BrunoRicci/DataloggerDHT22/Hardware/README.txt

Hardware files.
Schematics, simulations, measurements, PCB layouts and mechanical diagrams.
