BrunoRicci/DataloggerDHT22/Documentation/README.txt

Documentations for every project section and stage.
