BrunoRicci/DataloggerDHT22/Documentation/Web dashboard/last_connection_table.png

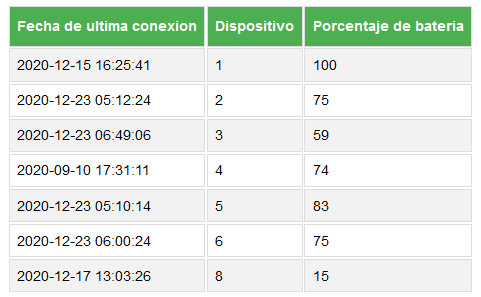
Documentation/Web dashboard/last_connection_table.png
