BrunoRicci/DataloggerDHT22/Hardware/Datalogger_esp8266/3d model/3d_complete.FCStd

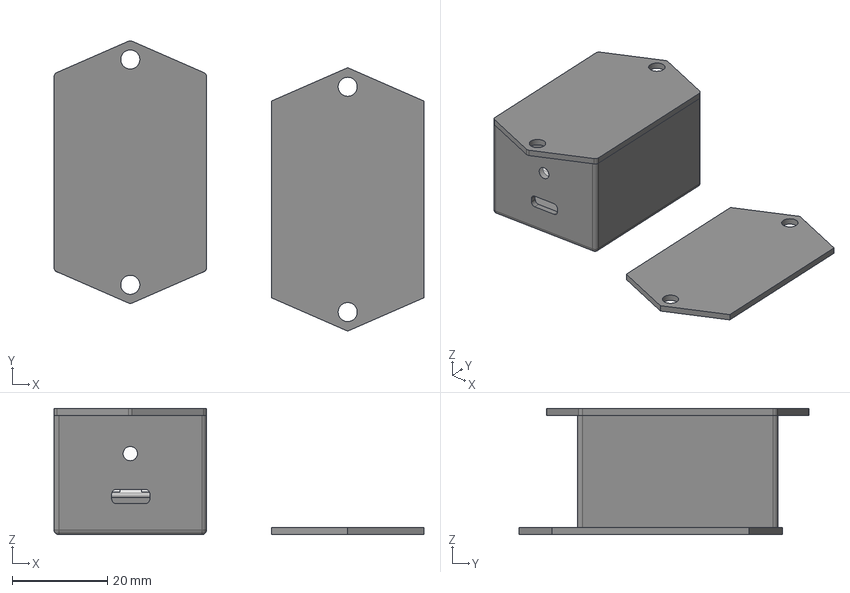
[picture p2: CAD file, 2020-11-16]
Hardware/Datalogger_esp8266/3d model/3d_complete.FCStd
77.6 x 60.9 x 26.5 mm
Battery
Cabinet_drilled
Cabinet_cover
LED_cover
