BrunoRicci/DataloggerDHT22/Hardware/Datalogger_esp8266/3d model/Datalogger_3d_pcb.step

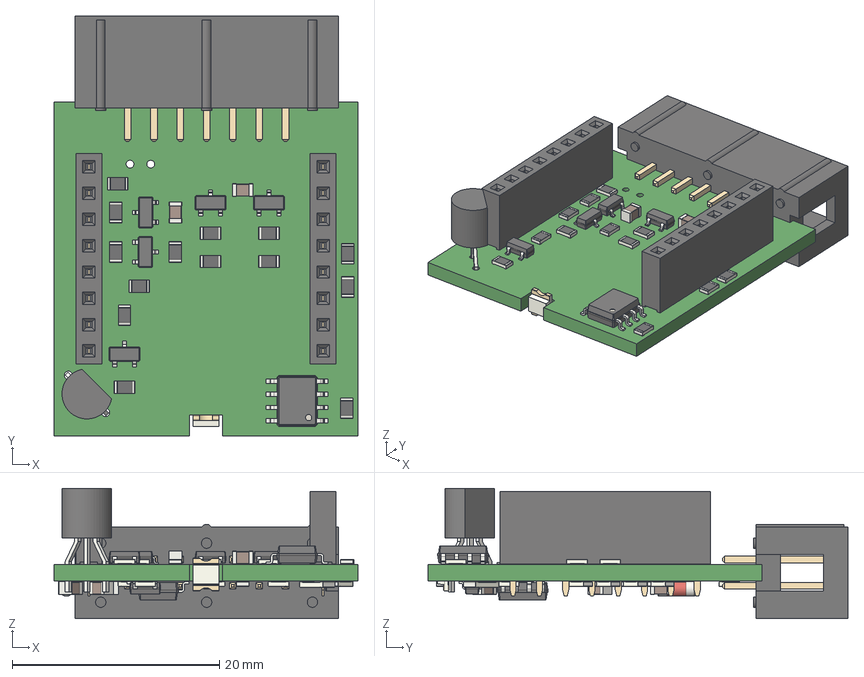
[picture p3: CAD file, 2020-11-16]
Hardware/Datalogger_esp8266/3d model/Datalogger_3d_pcb.step
29.4 x 40.5 x 12.6 mm
