BrunoRicci/DataloggerDHT22/Hardware/Datalogger_esp8266/LIR2477_battery_holder/LIR2477_battery_holder.FCStd

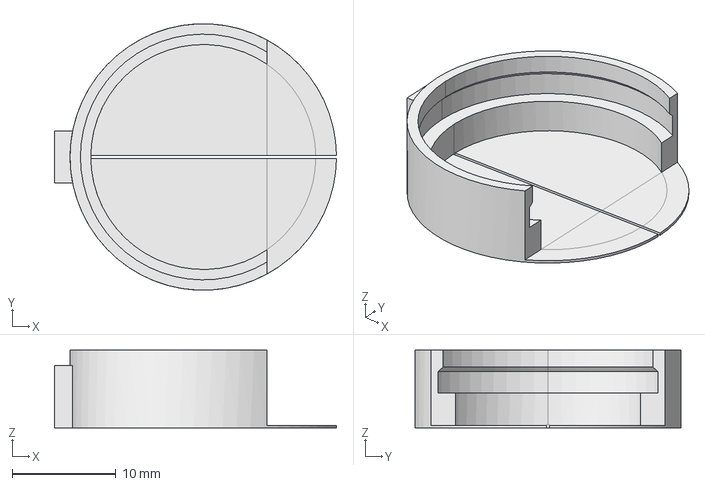
[picture p4: CAD file, 2020-06-24]
Hardware/Datalogger_esp8266/LIR2477_battery_holder/LIR2477_battery_holder.FCStd
27.2 x 25.7 x 7.50 mm
