BrunoRicci/DataloggerDHT22/(list of files, cad)

Other CAD files:
Hardware/Datalogger_esp8266/LIR2477_battery_holder/battery_holder.stl
Hardware/Datalogger_esp8266/3d model/3d_views.FCStd
