BrunoRicci/DataloggerDHT22/Documentation/Testing scripts/README.txt

Scripts for testing system performance and behaviors.
