BrunoRicci/DataloggerDHT22/Documentation/Testing scripts/Datos dataloggers/DATOS_06-08-2020/datos_23-07-2020_06-08-2020.csv

TIMESTAMP | DATE_TIME | ID_SENSOR | TEMPERATURE | HUMIDITY
1596744298 | 2020-08-06 17:04:58 | 1 | -0.1 | 255.0
1596744298 | 2020-08-06 17:04:58 | 2 | -0.1 | 255.0
1596744298 | 2020-08-06 17:04:58 | 3 | -0.1 | 255.0
1596744298 | 2020-08-06 17:04:58 | 4 | -0.1 | 255.0
1596740699 | 2020-08-06 16:04:59 | 1 | -0.1 | 255.0
1596740699 | 2020-08-06 16:04:59 | 2 | -0.1 | 255.0
1596740699 | 2020-08-06 16:04:59 | 3 | -0.1 | 255.0
1596740699 | 2020-08-06 16:04:59 | 4 | -0.1 | 255.0
1596737202 | 2020-08-06 15:06:42 | 17 | -0.1 | 255.0
1596737202 | 2020-08-06 15:06:42 | 18 | -0.1 | 255.0
1596737202 | 2020-08-06 15:06:42 | 19 | -0.1 | 255.0
1596737202 | 2020-08-06 15:06:42 | 20 | -0.1 | 255.0
1596737156 | 2020-08-06 15:05:56 | 13 | -0.1 | 255.0
1596737156 | 2020-08-06 15:05:56 | 14 | -0.1 | 255.0
1596737156 | 2020-08-06 15:05:56 | 15 | -0.1 | 255.0
1596737156 | 2020-08-06 15:05:56 | 16 | -0.1 | 255.0
1596737136 | 2020-08-06 15:05:36 | 9 | -0.1 | 255.0
1596737136 | 2020-08-06 15:05:36 | 10 | -0.1 | 255.0
1596737136 | 2020-08-06 15:05:36 | 11 | -0.1 | 255.0
1596737136 | 2020-08-06 15:05:36 | 12 | -0.1 | 255.0
1596737126 | 2020-08-06 15:05:26 | 5 | -0.1 | 255.0
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
