BrunoRicci/DataloggerDHT22/Documentation/Testing scripts/Datos dataloggers/DATOS_06-08-2020/datos_23-07-2020_06-08-2020.ods

TIMESTAMP | DATE_TIME | ID_SENSOR | TEMPERATURE | HUMIDITY
1595531435 | 2020-07-23 16:10:35 | 1
1595531436 | 2020-07-23 16:10:36 | 1
1595531437 | 2020-07-23 16:10:37 | 1
1595531438 | 2020-07-23 16:10:38 | 1
1595535034 | 2020-07-23 17:10:34 | 1
1595535035 | 2020-07-23 17:10:35 | 1
1595535036 | 2020-07-23 17:10:36 | 1
1595535037 | 2020-07-23 17:10:37 | 1
1595538633 | 2020-07-23 18:10:33 | 1
1595538634 | 2020-07-23 18:10:34 | 1
1595538635 | 2020-07-23 18:10:35 | 1
1595538636 | 2020-07-23 18:10:36 | 1
1595542232 | 2020-07-23 19:10:32 | 1
1595542233 | 2020-07-23 19:10:33 | 1
1595542234 | 2020-07-23 19:10:34 | 1
1595542235 | 2020-07-23 19:10:35 | 1
1595545831 | 2020-07-23 20:10:31 | 1
1595545832 | 2020-07-23 20:10:32 | 1
1595545833 | 2020-07-23 20:10:33 | 1
1595545834 | 2020-07-23 20:10:34 | 1
1595549430 | 2020-07-23 21:10:30 | 1
1595549431 | 2020-07-23 21:10:31 | 1
1595549432 | 2020-07-23 21:10:32 | 1
1595549433 | 2020-07-23 21:10:33 | 1
1595553029 | 2020-07-23 22:10:29 | 1
1595553030 | 2020-07-23 22:10:30 | 1
1595553031 | 2020-07-23 22:10:31 | 1
1595553032 | 2020-07-23 22:10:32 | 1
1595556628 | 2020-07-23 23:10:28 | 1
1595556629 | 2020-07-23 23:10:29 | 1
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
