BrunoRicci/DataloggerDHT22/Documentation/Testing scripts/Datos dataloggers/1/data_1_15-06-2020_30-06-2020.ods

ID_SENSOR | TEMPERATURE | HUMIDITY | Date | Time
4 |  |  | 15/06/20 | 14:30:00
3 |  |  | 15/06/20 | 14:30:00
2 |  |  | 15/06/20 | 14:30:00
1 |  |  | 15/06/20 | 14:30:00
4 |  |  | 15/06/20 | 15:29:59
3 |  |  | 15/06/20 | 15:29:59
2 |  |  | 15/06/20 | 15:29:59
1 |  |  | 15/06/20 | 15:29:59
4 |  |  | 15/06/20 | 16:29:58
3 |  |  | 15/06/20 | 16:29:58
2 |  |  | 15/06/20 | 16:29:58
1 |  |  | 15/06/20 | 16:29:58
4 | 4.4 | 50.0 | 15/06/20 | 17:29:57
3 | 5.3 | 57.0 | 15/06/20 | 17:29:57
2 | 4.7 | 51.0 | 15/06/20 | 17:29:57
1 | 5.0 | 55.0 | 15/06/20 | 17:29:57
4 | 3.8 | 49.0 | 15/06/20 | 18:29:56
3 | 4.3 | 56.0 | 15/06/20 | 18:29:56
2 | 4.2 | 51.0 | 15/06/20 | 18:29:56
1 | 4.2 | 55.0 | 15/06/20 | 18:29:56
4 | 3.8 | 49.0 | 15/06/20 | 19:29:55
3 | 4.3 | 56.0 | 15/06/20 | 19:29:55
2 | 4.2 | 51.0 | 15/06/20 | 19:29:55
1 | 4.2 | 55.0 | 15/06/20 | 19:29:55
4 | 3.8 | 49.0 | 15/06/20 | 20:29:53
3 | 4.3 | 56.0 | 15/06/20 | 20:29:53
2 | 4.2 | 51.0 | 15/06/20 | 20:29:53
1 | 4.2 | 55.0 | 15/06/20 | 20:29:53
4 | 3.8 | 49.0 | 15/06/20 | 21:29:52
3 | 4.3 | 56.0 | 15/06/20 | 21:29:52
2 | 4.2 | 51.0 | 15/06/20 | 21:29:52
1 | 4.1 | 55.0 | 15/06/20 | 21:29:52
4 | 4.4 | 50.0 | 15/06/20 | 22:29:51
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
