BrunoRicci/DataloggerDHT22/Documentation/Testing scripts/Datos dataloggers/1/data_1_v2.ods

TIMESTAMP | DATE_TIME | ID_SENSOR | TEMPERATURE | HUMIDITY | Date | Time | Corrected timestamp | Corrected time | Correction timestamp
1590055279 | 2020-05-21 07:01:19 | 4 | -0.1 | 255.0 | 15/06/20 | 12:32:24 | 1592235144 | 43997,5225 | 2179865
1590055279 | 2020-05-21 07:01:19 | 3 | -0.1 | 255.0 | 15/06/20 | 12:32:24 | 1592235144 | 43997,5225
1590055279 | 2020-05-21 07:01:19 | 2 | -0.1 | 255.0 | 15/06/20 | 12:32:24 | 1592235144 | 43997,5225
1590055279 | 2020-05-21 07:01:19 | 1 | -0.1 | 255.0 | 15/06/20 | 12:32:24 | 1592235144 | 43997,5225
1590062335 | 2020-05-21 08:58:55 | 4 | -0.1 | 255.0 | 15/06/20 | 14:30:00 | 1592242200 | 43997,6041666667
1590062335 | 2020-05-21 08:58:55 | 3 | -0.1 | 255.0 | 15/06/20 | 14:30:00 | 1592242200 | 43997,6041666667
1590062335 | 2020-05-21 08:58:55 | 2 | -0.1 | 255.0 | 15/06/20 | 14:30:00 | 1592242200 | 43997,6041666667
1590062335 | 2020-05-21 08:58:55 | 1 | -0.1 | 255.0 | 15/06/20 | 14:30:00 | 1592242200 | 43997,6041666667
1590065934 | 2020-05-21 09:58:54 | 4 | -0.1 | 255.0 | 15/06/20 | 15:29:59 | 1592245799 | 43997,6458217593
1590065934 | 2020-05-21 09:58:54 | 3 | -0.1 | 255.0 | 15/06/20 | 15:29:59 | 1592245799 | 43997,6458217593
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
