BrunoRicci/DataloggerDHT22/Documentation/Testing scripts/Datos dataloggers/2/data_2_15-06-2020_30-06-2020.ods

ID_SENSOR | TEMPERATURE | HUMIDITY | Date | Time
4 |  |  | 15/06/20 | 12:53:00
3 |  |  | 15/06/20 | 12:53:00
2 |  |  | 15/06/20 | 12:53:00
1 |  |  | 15/06/20 | 12:53:00
4 |  |  | 15/06/20 | 13:52:59
3 |  |  | 15/06/20 | 13:52:59
2 |  |  | 15/06/20 | 13:52:59
1 |  |  | 15/06/20 | 13:52:59
4 |  |  | 15/06/20 | 14:52:58
3 |  |  | 15/06/20 | 14:52:58
2 |  |  | 15/06/20 | 14:52:58
1 |  |  | 15/06/20 | 14:52:58
4 | 9.4 | 80.0 | 15/06/20 | 15:52:57
3 | 9.9 | 58.0 | 15/06/20 | 15:52:57
2 | 9.9 | 57.0 | 15/06/20 | 15:52:57
1 | 9.8 | 61.0 | 15/06/20 | 15:52:57
4 | 9.4 | 80.0 | 15/06/20 | 16:52:56
3 | 9.9 | 58.0 | 15/06/20 | 16:52:56
2 | 9.8 | 57.0 | 15/06/20 | 16:52:56
1 | 9.9 | 62.0 | 15/06/20 | 16:52:56
4 | 9.4 | 80.0 | 15/06/20 | 17:52:55
3 | 9.9 | 58.0 | 15/06/20 | 17:52:55
2 | 9.9 | 57.0 | 15/06/20 | 17:52:55
1 | 9.9 | 62.0 | 15/06/20 | 17:52:55
4 | 9.4 | 80.0 | 15/06/20 | 18:52:54
3 | 9.9 | 58.0 | 15/06/20 | 18:52:54
2 | 9.9 | 57.0 | 15/06/20 | 18:52:54
1 | 9.9 | 61.0 | 15/06/20 | 18:52:54
4 | 9.4 | 80.0 | 15/06/20 | 19:52:53
3 | 9.9 | 58.0 | 15/06/20 | 19:52:53
2 | 9.9 | 57.0 | 15/06/20 | 19:52:53
1 | 9.9 | 62.0 | 15/06/20 | 19:52:53
4 | 9.4 | 80.0 | 15/06/20 | 20:52:52
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
