BrunoRicci/DataloggerDHT22/Documentation/Testing scripts/Datos dataloggers/3/data_3_15-06-2020_30-06-2020.ods

ID_SENSOR | TEMPERATURE | HUMIDITY | Date | Time
4 | -0.1 | 255.0 | 15/06/20 | 14:45:00
3 | -0.1 | 255.0 | 15/06/20 | 14:45:00
2 | -0.1 | 255.0 | 15/06/20 | 14:45:00
1 | -0.1 | 255.0 | 15/06/20 | 14:45:00
4 | -0.1 | 255.0 | 15/06/20 | 15:44:58
3 | -0.1 | 255.0 | 15/06/20 | 15:44:58
2 | -0.1 | 255.0 | 15/06/20 | 15:44:58
1 | -0.1 | 255.0 | 15/06/20 | 15:44:58
4 | -0.1 | 255.0 | 15/06/20 | 16:44:57
3 | -0.1 | 255.0 | 15/06/20 | 16:44:57
2 | -0.1 | 255.0 | 15/06/20 | 16:44:57
1 | -0.1 | 255.0 | 15/06/20 | 16:44:57
4 | 11.9 | 53.0 | 15/06/20 | 17:44:56
3 | 11.7 | 51.0 | 15/06/20 | 17:44:56
2 | 12.0 | 53.0 | 15/06/20 | 17:44:56
1 | 12.0 | 58.0 | 15/06/20 | 17:44:56
4 | 11.5 | 52.0 | 15/06/20 | 18:44:55
3 | 11.4 | 51.0 | 15/06/20 | 18:44:55
2 | 11.6 | 53.0 | 15/06/20 | 18:44:55
1 | 11.6 | 58.0 | 15/06/20 | 18:44:55
4 | 11.5 | 52.0 | 15/06/20 | 19:44:54
3 | 11.4 | 51.0 | 15/06/20 | 19:44:54
2 | 11.6 | 53.0 | 15/06/20 | 19:44:54
1 | 11.6 | 58.0 | 15/06/20 | 19:44:54
4 | 13.6 | 54.0 | 15/06/20 | 20:44:53
3 | 13.5 | 53.0 | 15/06/20 | 20:44:53
2 | 13.7 | 55.0 | 15/06/20 | 20:44:53
1 | 13.8 | 60.0 | 15/06/20 | 20:44:53
4 | 16.6 | 54.0 | 15/06/20 | 21:44:52
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
