BrunoRicci/DataloggerDHT22/Documentation/Testing scripts/Datos dataloggers/3/data_3_2.csv

TIMESTAMP | DATE_TIME | ID_SENSOR | TEMPERATURE | HUMIDITY
1 | 1969-12-31 21:00:01 | 1 | 22.3 | 75.0
1 | 1969-12-31 21:00:01 | 2 | 22.1 | 70.0
1 | 1969-12-31 21:00:01 | 3 | 22.3 | 77.0
1 | 1969-12-31 21:00:01 | 4 | 22.5 | 76.0
300 | 1969-12-31 21:05:00 | 1 | 22.1 | 75.0
300 | 1969-12-31 21:05:00 | 2 | 22.0 | 70.0
300 | 1969-12-31 21:05:00 | 3 | 22.2 | 77.0
300 | 1969-12-31 21:05:00 | 4 | 22.4 | 76.0
599 | 1969-12-31 21:09:59 | 1 | 22.2 | 76.0
599 | 1969-12-31 21:09:59 | 2 | 22.0 | 71.0
599 | 1969-12-31 21:09:59 | 3 | 22.2 | 78.0
599 | 1969-12-31 21:09:59 | 4 | 22.3 | 77.0
898 | 1969-12-31 21:14:58 | 1 | 22.1 | 75.0
898 | 1969-12-31 21:14:58 | 2 | 22.0 | 70.0
898 | 1969-12-31 21:14:58 | 3 | 22.2 | 78.0
898 | 1969-12-31 21:14:58 | 4 | 22.4 | 77.0
1197 | 1969-12-31 21:19:57 | 1 | 22.2 | 76.0
1197 | 1969-12-31 21:19:57 | 2 | 22.1 | 71.0
1197 | 1969-12-31 21:19:57 | 3 | 22.3 | 80.0
1197 | 1969-12-31 21:19:57 | 4 | 22.4 | 78.0
1496 | 1969-12-31 21:24:56 | 1 | 22.3 | 75.0
1496 | 1969-12-31 21:24:56 | 2 | 22.1 | 70.0
1496 | 1969-12-31 21:24:56 | 3 | 22.3 | 77.0
1496 | 1969-12-31 21:24:56 | 4 | 22.5 | 75.0
1795 | 1969-12-31 21:29:55 | 1 | 22.2 | 75.0
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
