BrunoRicci/DataloggerDHT22/Documentation/Testing scripts/Datos dataloggers/4/data_4_15-06-2020_30-06-2020.ods

ID_SENSOR | TEMPERATURE | HUMIDITY | Date | Time
4 | -0.1 | 255.0 | 15/06/20 | 09:07:04
3 | -0.1 | 255.0 | 15/06/20 | 09:07:04
2 | -0.1 | 255.0 | 15/06/20 | 09:07:04
1 | 18.4 | 58.0 | 15/06/20 | 09:07:04
4 | -0.1 | 255.0 | 15/06/20 | 10:07:03
3 | -0.1 | 255.0 | 15/06/20 | 10:07:03
2 | -0.1 | 255.0 | 15/06/20 | 10:07:03
1 | 19.4 | 59.0 | 15/06/20 | 10:07:03
4 | -0.1 | 255.0 | 15/06/20 | 11:07:02
3 | -0.1 | 255.0 | 15/06/20 | 11:07:02
2 | -0.1 | 255.0 | 15/06/20 | 11:07:02
1 | 19.6 | 59.0 | 15/06/20 | 11:07:02
4 | -0.1 | 255.0 | 15/06/20 | 12:07:01
3 | -0.1 | 255.0 | 15/06/20 | 12:07:01
2 | -0.1 | 255.0 | 15/06/20 | 12:07:01
1 | 19.7 | 59.0 | 15/06/20 | 12:07:01
4 | -0.1 | 255.0 | 15/06/20 | 13:07:00
3 | -0.1 | 255.0 | 15/06/20 | 13:07:00
2 | -0.1 | 255.0 | 15/06/20 | 13:07:00
1 | -0.1 | 255.0 | 15/06/20 | 13:07:00
4 | -0.1 | 255.0 | 15/06/20 | 14:06:59
3 | -0.1 | 255.0 | 15/06/20 | 14:06:59
2 | -0.1 | 255.0 | 15/06/20 | 14:06:59
1 | -0.1 | 255.0 | 15/06/20 | 14:06:59
4 | -0.1 | 255.0 | 15/06/20 | 15:06:58
3 | -0.1 | 255.0 | 15/06/20 | 15:06:58
2 | -0.1 | 255.0 | 15/06/20 | 15:06:58
1 | 19.5 | 59.0 | 15/06/20 | 15:06:58
4 | -0.1 | 255.0 | 15/06/20 | 16:06:57
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
