BrunoRicci/DataloggerDHT22/Documentation/Testing scripts/Datos dataloggers/5/data_5_15-06-2020_30-06-2020.ods

ID_SENSOR | TEMPERATURE | HUMIDITY | Date | Time
4 |  |  | 15/06/20 | 13:20:00
3 |  |  | 15/06/20 | 13:20:00
2 |  |  | 15/06/20 | 13:20:00
1 |  |  | 15/06/20 | 13:20:00
4 |  |  | 15/06/20 | 14:19:59
3 |  |  | 15/06/20 | 14:19:59
2 |  |  | 15/06/20 | 14:19:59
1 |  |  | 15/06/20 | 14:19:59
4 |  |  | 15/06/20 | 15:19:58
3 |  |  | 15/06/20 | 15:19:58
2 |  |  | 15/06/20 | 15:19:58
1 |  |  | 15/06/20 | 15:19:58
4 | 29.4 | 52.0 | 15/06/20 | 16:19:57
3 | 29.7 | 51.0 | 15/06/20 | 16:19:57
2 | 29.1 | 51.0 | 15/06/20 | 16:19:57
1 | 29.6 | 55.0 | 15/06/20 | 16:19:57
4 | 29.1 | 52.0 | 15/06/20 | 17:19:56
3 | 29.5 | 51.0 | 15/06/20 | 17:19:56
2 | 29.0 | 51.0 | 15/06/20 | 17:19:56
1 | 29.3 | 55.0 | 15/06/20 | 17:19:56
4 | 29.1 | 52.0 | 15/06/20 | 18:19:55
3 | 29.4 | 51.0 | 15/06/20 | 18:19:55
2 | 29.0 | 51.0 | 15/06/20 | 18:19:55
1 | 29.3 | 55.0 | 15/06/20 | 18:19:55
4 | 29.1 | 52.0 | 15/06/20 | 19:19:54
3 | 29.5 | 51.0 | 15/06/20 | 19:19:54
2 | 29.0 | 51.0 | 15/06/20 | 19:19:54
1 | 29.3 | 55.0 | 15/06/20 | 19:19:54
4 | 29.0 | 52.0 | 15/06/20 | 20:19:53
3 | 29.5 | 51.0 | 15/06/20 | 20:19:53
2 | 29.0 | 51.0 | 15/06/20 | 20:19:53
1 | 29.3 | 55.0 | 15/06/20 | 20:19:53
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
