BrunoRicci/DataloggerDHT22/Documentation/Testing scripts/Datos dataloggers/5/data_5_2.ods

TIMESTAMP | DATE_TIME | ID_SENSOR | TEMPERATURE | HUMIDITY |  |  | 13:20:00
1590062511 | 2020-05-21 09:01:51 | 4 | -0.1 | 255.0 | 1592238000 | 43997,5555555556 | 2175489
1590062511 | 2020-05-21 09:01:51 | 3 | -0.1 | 255.0 | 1592238000 | 43997,5555555556
1590062511 | 2020-05-21 09:01:51 | 2 | -0.1 | 255.0 | 1592238000 | 43997,5555555556
1590062511 | 2020-05-21 09:01:51 | 1 | -0.1 | 255.0 | 1592238000 | 43997,5555555556
1590066110 | 2020-05-21 10:01:50 | 4 | -0.1 | 255.0 | 1592241599 | 43997,5972106482
1590066110 | 2020-05-21 10:01:50 | 3 | -0.1 | 255.0 | 1592241599 | 43997,5972106482
1590066110 | 2020-05-21 10:01:50 | 2 | -0.1 | 255.0 | 1592241599 | 43997,5972106482
1590066110 | 2020-05-21 10:01:50 | 1 | -0.1 | 255.0 | 1592241599 | 43997,5972106482
1590069709 | 2020-05-21 11:01:49 | 4 | -0.1 | 255.0 | 1592245198 | 43997,6388657407
1590069709 | 2020-05-21 11:01:49 | 3 | -0.1 | 255.0 | 1592245198 | 43997,6388657407
1590069709 | 2020-05-21 11:01:49 | 2 | -0.1 | 255.0 | 1592245198 | 43997,6388657407
1590069709 | 2020-05-21 11:01:49 | 1 | -0.1 | 255.0 | 1592245198 | 43997,6388657407
1590073308 | 2020-05-21 12:01:48 | 4 | 29.4 | 52.0 | 1592248797 | 43997,6805208333
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
