BrunoRicci/DataloggerDHT22/Documentation/Testing scripts/Datos dataloggers/2/data_2.ods

TIMESTAMP | DATE_TIME | ID_SENSOR | TEMPERATURE | HUMIDITY
1590066305 | 2020-05-21 10:05:05 | 4
1590066305 | 2020-05-21 10:05:05 | 3
1590066305 | 2020-05-21 10:05:05 | 2
1590066305 | 2020-05-21 10:05:05 | 1
1590069904 | 2020-05-21 11:05:04 | 4
1590069904 | 2020-05-21 11:05:04 | 3
1590069904 | 2020-05-21 11:05:04 | 2
1590069904 | 2020-05-21 11:05:04 | 1
1590073498 | 2020-05-21 12:04:58 | 4
1590073498 | 2020-05-21 12:04:58 | 3
1590073498 | 2020-05-21 12:04:58 | 2
1590073498 | 2020-05-21 12:04:58 | 1
1590077097 | 2020-05-21 13:04:57 | 4 | 20,8 | 80
1590077097 | 2020-05-21 13:04:57 | 3 | 21,2 | 59
1590077097 | 2020-05-21 13:04:57 | 2 | 21,3 | 58
1590077097 | 2020-05-21 13:04:57 | 1 | 21,4 | 62
1590080696 | 2020-05-21 14:04:56 | 4 | 20,9 | 83
1590080696 | 2020-05-21 14:04:56 | 3 | 21,2 | 61
1590080696 | 2020-05-21 14:04:56 | 2 | 21,5 | 60
1590080696 | 2020-05-21 14:04:56 | 1 | 21,4 | 64
1590084295 | 2020-05-21 15:04:55 | 4 | 12,8 | 75
1590084295 | 2020-05-21 15:04:55 | 3 | 14,7 | 54
1590084295 | 2020-05-21 15:04:55 | 2 | 14,3 | 51
1590084295 | 2020-05-21 15:04:55 | 1 | 13,6 | 58
1590087894 | 2020-05-21 16:04:54 | 4 | 9,6 | 74
1590087894 | 2020-05-21 16:04:54 | 3 | 10,2 | 56
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
