BrunoRicci/DataloggerDHT22/Documentation/Testing scripts/Datos dataloggers/4/data_4.ods

TIMESTAMP | DATE_TIME | ID_SENSOR | TEMPERATURE | HUMIDITY
1590061097 | 2020-05-21 08:38:17 | 4
1590061097 | 2020-05-21 08:38:17 | 3
1590061097 | 2020-05-21 08:38:17 | 2
1590061097 | 2020-05-21 08:38:17 | 1
1590064701 | 2020-05-21 09:38:21 | 4
1590064701 | 2020-05-21 09:38:21 | 3
1590064701 | 2020-05-21 09:38:21 | 2
1590064701 | 2020-05-21 09:38:21 | 1
1590065645 | 2020-05-21 09:54:05 | 4
1590065645 | 2020-05-21 09:54:05 | 3
1590065645 | 2020-05-21 09:54:05 | 2
1590065645 | 2020-05-21 09:54:05 | 1
1590069244 | 2020-05-21 10:54:04 | 4
1590069244 | 2020-05-21 10:54:04 | 3
1590069244 | 2020-05-21 10:54:04 | 2
1590069244 | 2020-05-21 10:54:04 | 1
1590072843 | 2020-05-21 11:54:03 | 4
1590072843 | 2020-05-21 11:54:03 | 3
1590072843 | 2020-05-21 11:54:03 | 2
1590072843 | 2020-05-21 11:54:03 | 1
1590076442 | 2020-05-21 12:54:02 | 4
1590076442 | 2020-05-21 12:54:02 | 3
1590076442 | 2020-05-21 12:54:02 | 2
1590076442 | 2020-05-21 12:54:02 | 1
1590080041 | 2020-05-21 13:54:01 | 4
1590080041 | 2020-05-21 13:54:01 | 3
1590080041 | 2020-05-21 13:54:01 | 2
1590080041 | 2020-05-21 13:54:01 | 1
1590083640 | 2020-05-21 14:54:00 | 4
1590083640 | 2020-05-21 14:54:00 | 3
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
