BrunoRicci/DataloggerDHT22/Tests web server/Python/webserver/backup_database/db10-09-2020/datos_10-09-2020.csv

TIMESTAMP | DATE_TIME | ID_SENSOR | TEMPERATURE | HUMIDITY
1596732022 | 2020-08-06 13:40:22 | 1 | 4.6 | 49.0
1596732022 | 2020-08-06 13:40:22 | 2 | 5.6 | 45.0
1596732022 | 2020-08-06 13:40:22 | 3 | 5.1 | 51.0
1596732022 | 2020-08-06 13:40:22 | 4 | 5.0 | 45.0
1596735621 | 2020-08-06 14:40:21 | 1 | 4.4 | 49.0
1596735621 | 2020-08-06 14:40:21 | 2 | 5.3 | 45.0
1596735621 | 2020-08-06 14:40:21 | 3 | 4.9 | 50.0
1596735621 | 2020-08-06 14:40:21 | 4 | 4.8 | 45.0
1596739220 | 2020-08-06 15:40:20 | 1 | 4.4 | 49.0
1596739220 | 2020-08-06 15:40:20 | 2 | 5.3 | 45.0
1596739220 | 2020-08-06 15:40:20 | 3 | 4.9 | 50.0
1596739220 | 2020-08-06 15:40:20 | 4 | 4.8 | 45.0
1596742819 | 2020-08-06 16:40:19 | 1 | 4.3 | 49.0
1596742819 | 2020-08-06 16:40:19 | 2 | 5.2 | 45.0
1596742819 | 2020-08-06 16:40:19 | 3 | 4.8 | 50.0
1596742819 | 2020-08-06 16:40:19 | 4 | 4.6 | 45.0
1596746418 | 2020-08-06 17:40:18 | 1 | 5.8 | 49.0
1596746418 | 2020-08-06 17:40:18 | 2 | 6.4 | 46.0
1596746418 | 2020-08-06 17:40:18 | 3 | 6.0 | 52.0
1596746418 | 2020-08-06 17:40:18 | 4 | 5.6 | 46.0
1596750017 | 2020-08-06 18:40:17 | 1 | 4.3 | 49.0
1596750017 | 2020-08-06 18:40:17 | 2 | 5.1 | 45.0
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
