BrunoRicci/DataloggerDHT22/Documentation/Testing scripts/Datos dataloggers/2/data_2.csv

TIMESTAMP | DATE_TIME | ID_SENSOR | TEMPERATURE | HUMIDITY
1 | 1969-12-31 21:00:01 | 1 | -0.1 | 255.0
1 | 1969-12-31 21:00:01 | 2 | -0.1 | 255.0
1 | 1969-12-31 21:00:01 | 3 | -0.1 | 255.0
1 | 1969-12-31 21:00:01 | 4 | -0.1 | 255.0
3600 | 1969-12-31 22:00:00 | 1 | -0.1 | 255.0
3600 | 1969-12-31 22:00:00 | 2 | -0.1 | 255.0
3600 | 1969-12-31 22:00:00 | 3 | -0.1 | 255.0
3600 | 1969-12-31 22:00:00 | 4 | -0.1 | 255.0
7199 | 1969-12-31 22:59:59 | 1 | -0.1 | 255.0
7199 | 1969-12-31 22:59:59 | 2 | -0.1 | 255.0
7199 | 1969-12-31 22:59:59 | 3 | -0.1 | 255.0
7199 | 1969-12-31 22:59:59 | 4 | -0.1 | 255.0
10803 | 1970-01-01 00:00:03 | 1 | -0.1 | 255.0
10803 | 1970-01-01 00:00:03 | 2 | -0.1 | 255.0
10803 | 1970-01-01 00:00:03 | 3 | -0.1 | 255.0
10803 | 1970-01-01 00:00:03 | 4 | -0.1 | 255.0
1590066305 | 2020-05-21 10:05:05 | 1 | -0.1 | 255.0
1590066305 | 2020-05-21 10:05:05 | 2 | -0.1 | 255.0
1590066305 | 2020-05-21 10:05:05 | 3 | -0.1 | 255.0
1590066305 | 2020-05-21 10:05:05 | 4 | -0.1 | 255.0
1590069904 | 2020-05-21 11:05:04 | 1 | -0.1 | 255.0
1590069904 | 2020-05-21 11:05:04 | 2 | -0.1 | 255.0
1590069904 | 2020-05-21 11:05:04 | 3 | -0.1 | 255.0
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
