BrunoRicci/DataloggerDHT22/Documentation/Testing scripts/Datos dataloggers/4/data_4_2.csv

TIMESTAMP | DATE_TIME | ID_SENSOR | TEMPERATURE | HUMIDITY
1 | 1969-12-31 21:00:01 | 1 | -0.1 | 255.0
1 | 1969-12-31 21:00:01 | 2 | -0.1 | 255.0
1 | 1969-12-31 21:00:01 | 3 | -0.1 | 255.0
1 | 1969-12-31 21:00:01 | 4 | -0.1 | 255.0
305 | 1969-12-31 21:05:05 | 1 | -0.1 | 255.0
305 | 1969-12-31 21:05:05 | 2 | -0.1 | 255.0
305 | 1969-12-31 21:05:05 | 3 | -0.1 | 255.0
305 | 1969-12-31 21:05:05 | 4 | -0.1 | 255.0
1590002943 | 2020-05-20 16:29:03 | 1 | -0.1 | 255.0
1590002943 | 2020-05-20 16:29:03 | 2 | -0.1 | 255.0
1590002943 | 2020-05-20 16:29:03 | 3 | -0.1 | 255.0
1590002943 | 2020-05-20 16:29:03 | 4 | -0.1 | 255.0
1590003247 | 2020-05-20 16:34:07 | 1 | -0.1 | 255.0
1590003247 | 2020-05-20 16:34:07 | 2 | -0.1 | 255.0
1590003247 | 2020-05-20 16:34:07 | 3 | -0.1 | 255.0
1590003247 | 2020-05-20 16:34:07 | 4 | -0.1 | 255.0
1590004691 | 2020-05-20 16:58:11 | 1 | -0.1 | 255.0
1590004691 | 2020-05-20 16:58:11 | 2 | -0.1 | 255.0
1590004691 | 2020-05-20 16:58:11 | 3 | -0.1 | 255.0
1590004691 | 2020-05-20 16:58:11 | 4 | -0.1 | 255.0
1590004990 | 2020-05-20 17:03:10 | 1 | -0.1 | 255.0
1590004990 | 2020-05-20 17:03:10 | 2 | -0.1 | 255.0
1590004990 | 2020-05-20 17:03:10 | 3 | -0.1 | 255.0
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
