BrunoRicci/DataloggerDHT22/Documentation/Testing scripts/Datos dataloggers/1/data_1.ods

TIMESTAMP | DATE_TIME | ID_SENSOR | TEMPERATURE | HUMIDITY
1590004291 | 2020-05-20 16:51:31 | 1 | -0.1 | 255.0
1590004291 | 2020-05-20 16:51:31 | 2 | -0.1 | 255.0
1590004291 | 2020-05-20 16:51:31 | 3 | -0.1 | 255.0
1590004291 | 2020-05-20 16:51:31 | 4 | -0.1 | 255.0
1590004590 | 2020-05-20 16:56:30 | 1 | -0.1 | 255.0
1590004590 | 2020-05-20 16:56:30 | 2 | -0.1 | 255.0
1590004590 | 2020-05-20 16:56:30 | 3 | -0.1 | 255.0
1590004590 | 2020-05-20 16:56:30 | 4 | -0.1 | 255.0
1590004889 | 2020-05-20 17:01:29 | 1 | 22.4 | 85.0
1590004889 | 2020-05-20 17:01:29 | 2 | 22.4 | 80.0
1590004889 | 2020-05-20 17:01:29 | 3 | 22.5 | 81.0
1590004889 | 2020-05-20 17:01:29 | 4 | 22.1 | 79.0
1590005188 | 2020-05-20 17:06:28 | 1 | 22.2 | 85.0
1590005188 | 2020-05-20 17:06:28 | 2 | 22.4 | 79.0
1590005188 | 2020-05-20 17:06:28 | 3 | 22.4 | 80.0
1590005188 | 2020-05-20 17:06:28 | 4 | 21.9 | 78.0
1590005487 | 2020-05-20 17:11:27 | 1 | 22.2 | 85.0
1590005487 | 2020-05-20 17:11:27 | 2 | 22.3 | 80.0
1590005487 | 2020-05-20 17:11:27 | 3 | 22.3 | 81.0
1590005487 | 2020-05-20 17:11:27 | 4 | 21.9 | 79.0
1590005786 | 2020-05-20 17:16:26 | 1 | 22.2 | 86.0
1590005786 | 2020-05-20 17:16:26 | 2 | 22.3 | 80.0
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
