BrunoRicci/DataloggerDHT22/Documentation/Testing scripts/Datos dataloggers/1/data_1.csv

TIMESTAMP | DATE_TIME | ID_SENSOR | TEMPERATURE | HUMIDITY
1 | 1969-12-31 21:00:01 | 1 | -0.1 | 255.0
1 | 1969-12-31 21:00:01 | 2 | -0.1 | 255.0
1 | 1969-12-31 21:00:01 | 3 | -0.1 | 255.0
1 | 1969-12-31 21:00:01 | 4 | -0.1 | 255.0
300 | 1969-12-31 21:05:00 | 1 | -0.1 | 255.0
300 | 1969-12-31 21:05:00 | 2 | -0.1 | 255.0
300 | 1969-12-31 21:05:00 | 3 | -0.1 | 255.0
300 | 1969-12-31 21:05:00 | 4 | -0.1 | 255.0
604 | 1969-12-31 21:10:04 | 1 | -0.1 | 255.0
604 | 1969-12-31 21:10:04 | 2 | -0.1 | 255.0
604 | 1969-12-31 21:10:04 | 3 | -0.1 | 255.0
604 | 1969-12-31 21:10:04 | 4 | -0.1 | 255.0
1590004291 | 2020-05-20 16:51:31 | 1 | -0.1 | 255.0
1590004291 | 2020-05-20 16:51:31 | 2 | -0.1 | 255.0
1590004291 | 2020-05-20 16:51:31 | 3 | -0.1 | 255.0
1590004291 | 2020-05-20 16:51:31 | 4 | -0.1 | 255.0
1590004590 | 2020-05-20 16:56:30 | 1 | -0.1 | 255.0
1590004590 | 2020-05-20 16:56:30 | 2 | -0.1 | 255.0
1590004590 | 2020-05-20 16:56:30 | 3 | -0.1 | 255.0
1590004590 | 2020-05-20 16:56:30 | 4 | -0.1 | 255.0
1590004889 | 2020-05-20 17:01:29 | 1 | 22.4 | 85.0
1590004889 | 2020-05-20 17:01:29 | 2 | 22.4 | 80.0
1590004889 | 2020-05-20 17:01:29 | 3 | 22.5 | 81.0
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
