BrunoRicci/DataloggerDHT22/(threads)

Thread 1 (2021-03-06):

Config mode AP responding too slow or intermittently.

BrunoRicci, 2021-03-06:
When into configuration mode, the AP created by the ESP8266 will assign IP after a while, and after that it won't respond every ping sent from the connected device. It just seems to "freeze" most of the time and only respond the ping requests during bursts of  short periods of time (5 seconds).

This happens in different hardware pieces, so hardware failure is discarded. This started to happen since last firmware version which included WPA2-Enterprise capabilities.

Possible solution: deactivate wifi enterprise auth after turning on access point.
