BrunoRicci/DataloggerDHT22/Hardware/Datalogger_esp8266/Datalogger_esp8266_backup-B_Cu.pdf

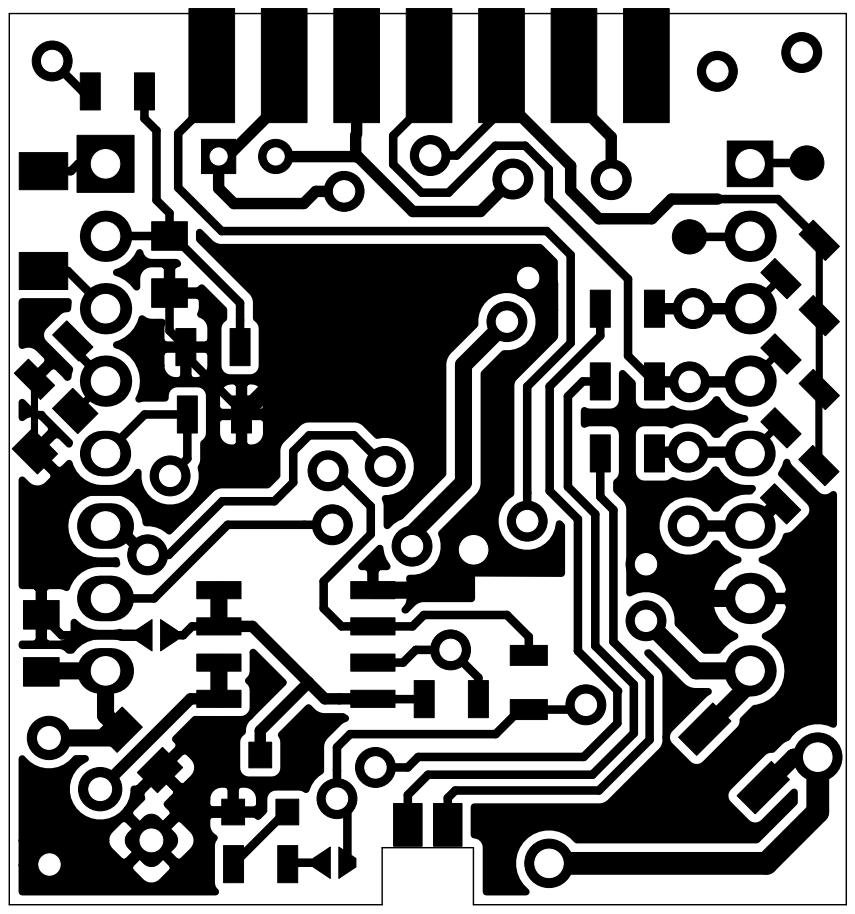
[picture p5: page 1]
