BrunoRicci/DataloggerDHT22/Hardware/Datalogger_esp8266/Datalogger_esp8266_backup-F_Cu.pdf

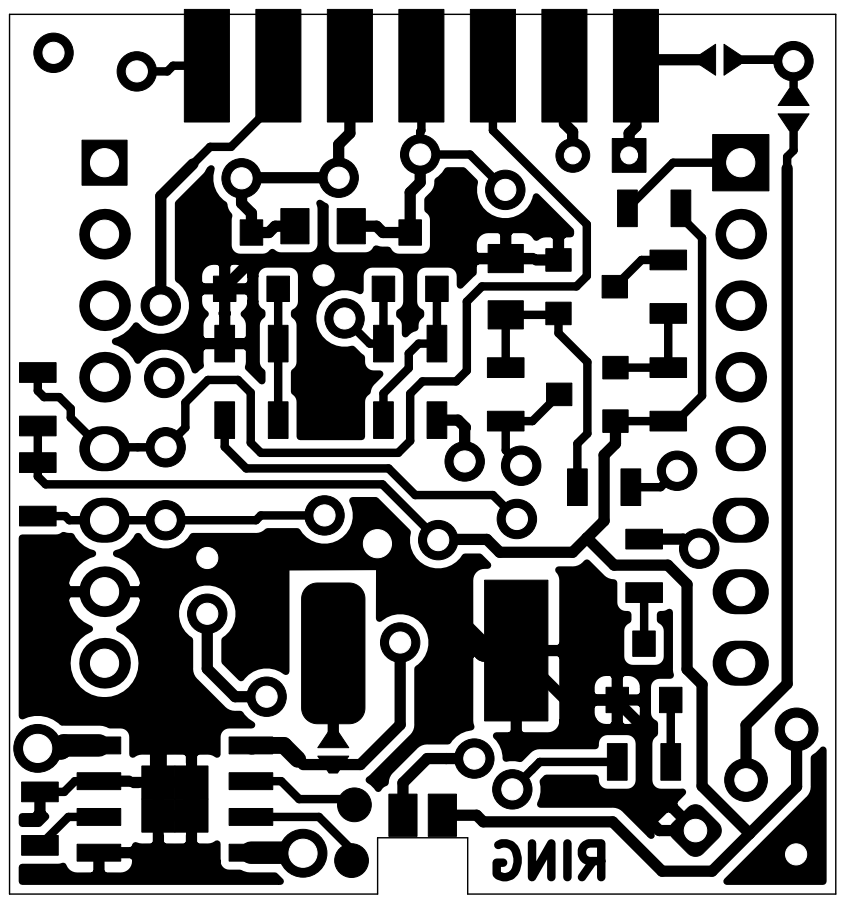
[picture p6: page 1]
