BrunoRicci/DataloggerDHT22/Hardware/Datalogger_esp8266/Datalogger_esp8266_FAB_BACK.pdf

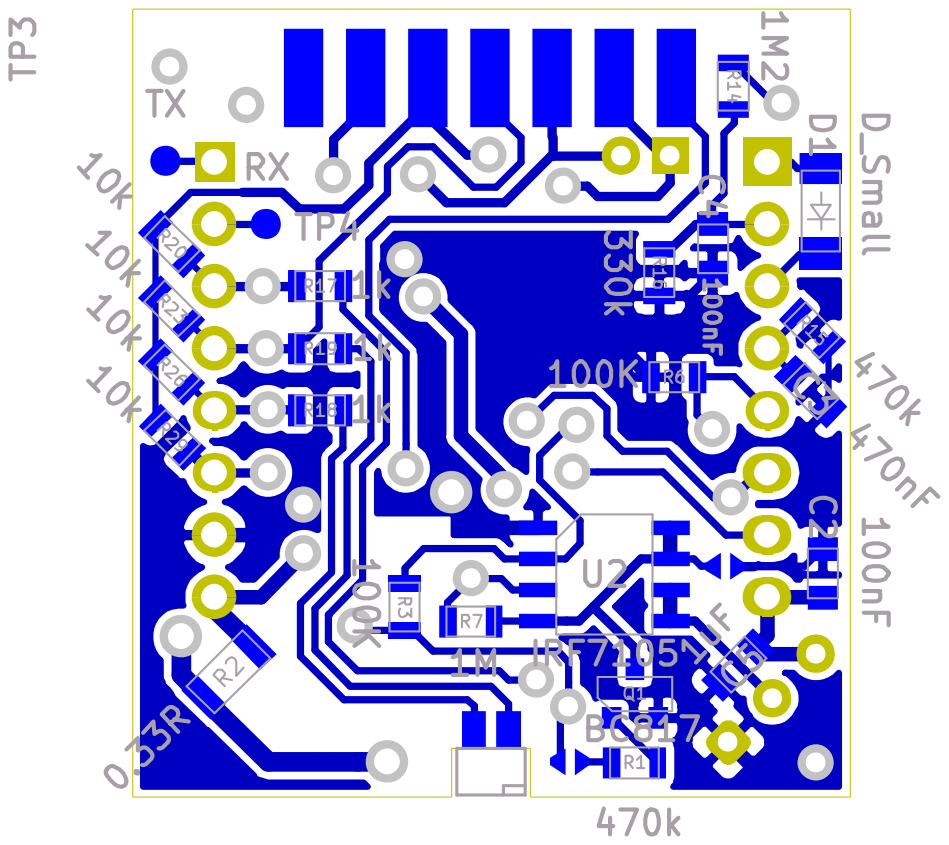
[picture p7: page 1]
