BrunoRicci/DataloggerDHT22/Hardware/Datalogger_esp8266/Datalogger_esp8266_FAB_FRONT.pdf

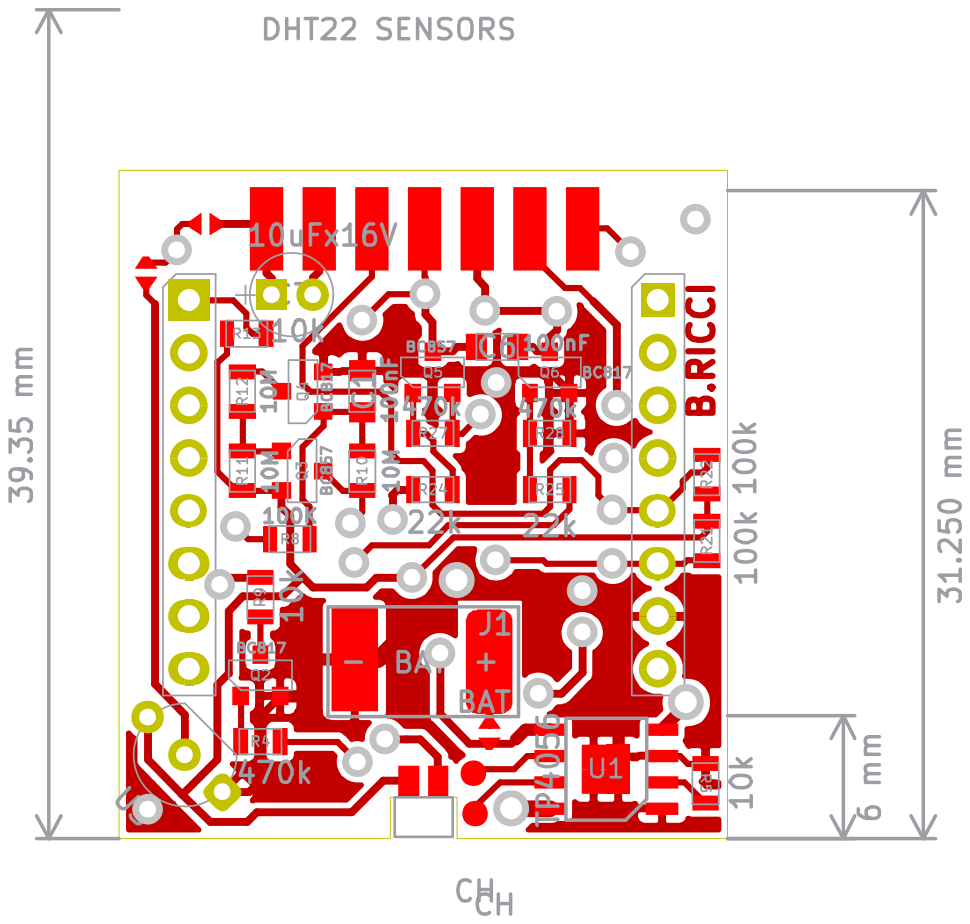
[picture p8: page 1]
