BrunoRicci/DataloggerDHT22/Hardware/Datalogger_esp8266/Datalogger_esp8266_PANELIZED-B_Cu.pdf

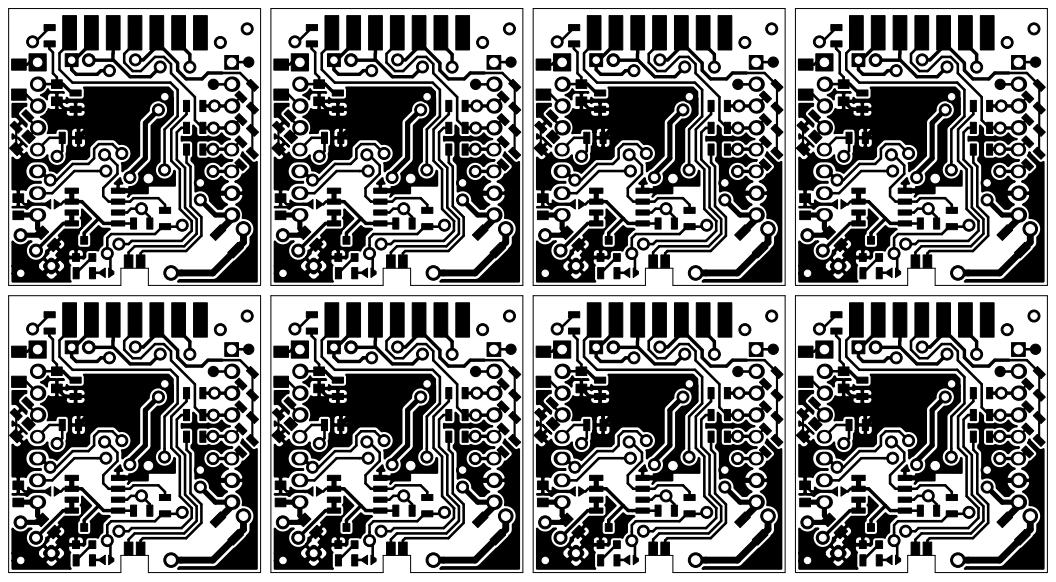
[picture p9: page 1]
