BrunoRicci/DataloggerDHT22/Hardware/Datalogger_esp8266/Datalogger_esp8266_PANELIZED-F_Cu.pdf

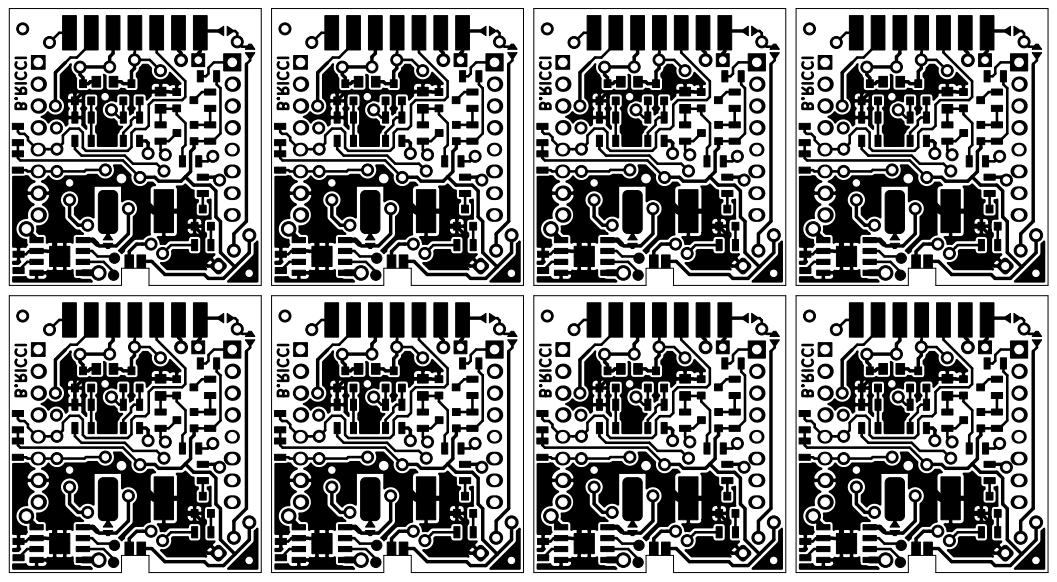
[picture p10: page 1]

B.RICCI B.RICCI B.RICCI B.RICCI
