BrunoRicci/DataloggerDHT22/Hardware/Datalogger_esp8266/Sensor_PCB/Sensor_PCB/Sensor_PCB_PANELIZED-F_Cu.pdf

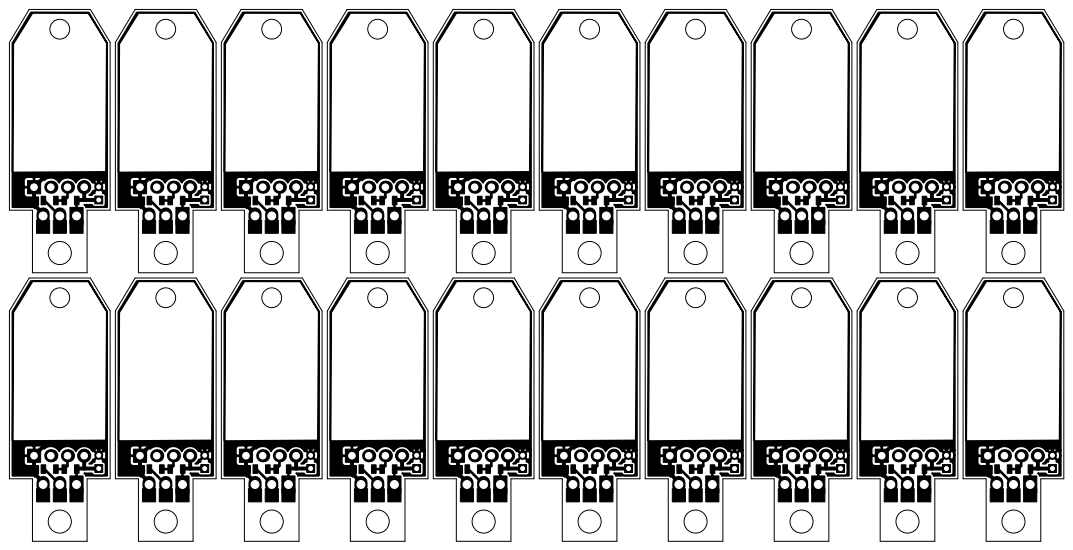
[picture p11: page 1]
