BrunoRicci/DataloggerDHT22/Hardware/Datalogger_esp8266/Sensor_PCB/Sensor_PCB/Sensor_PCB.kicad_pcb

## KiCad design Hardware/Datalogger_esp8266/Sensor_PCB/Sensor_PCB/Sensor_PCB.kicad_pcb (2020-06-24)

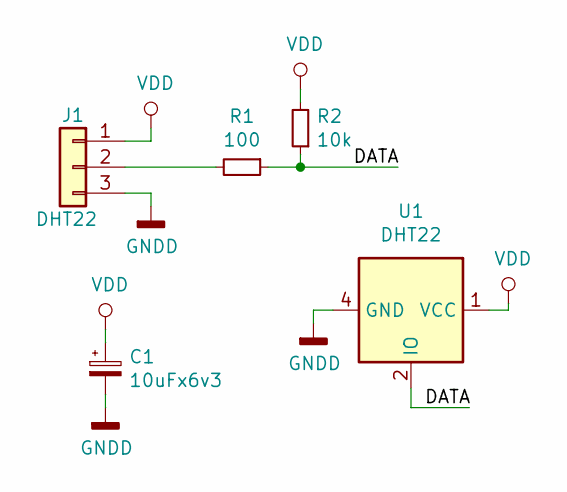
[picture p12: schematic Sensor_PCB.sch]

Parts:
C1: 10uFx6v3; CP_Radial_D4.0mm_P2.00mm
J1: DHT22; Molex_KK-6410-03_03x2.54mm_Straight
R1: 100; R_0805
R2: 10k; R_0805
U1: DHT22; Pin_Header_Straight_1x04_Pitch2.54mm

Connections:
/DATA: R1.1, R2.1, U1.2 (IO)
GNDD: C1.2, J1.3, U1.4 (GND)
unnamed: J1.2, R1.2
VDD: C1.1, J1.1, R2.2, U1.1 (VCC)

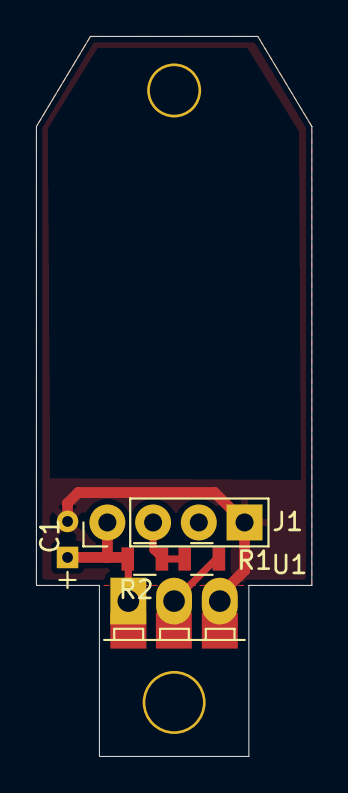
[picture p13: board Sensor_PCB.kicad_pcb from above]

Board: 2 copper layers, 15.3 x 40.0 mm, 6 parts (0 on the bottom side), 4 nets.

Other parts of the board:
e: e; MountingHole_3.2mm_M3_DIN965_Pad
