BrunoRicci/DataloggerDHT22/Hardware/Datalogger_esp8266/Datalogger_esp8266.kicad_pcb

## KiCad design Hardware/Datalogger_esp8266/Datalogger_esp8266.kicad_pcb (2020-06-24)

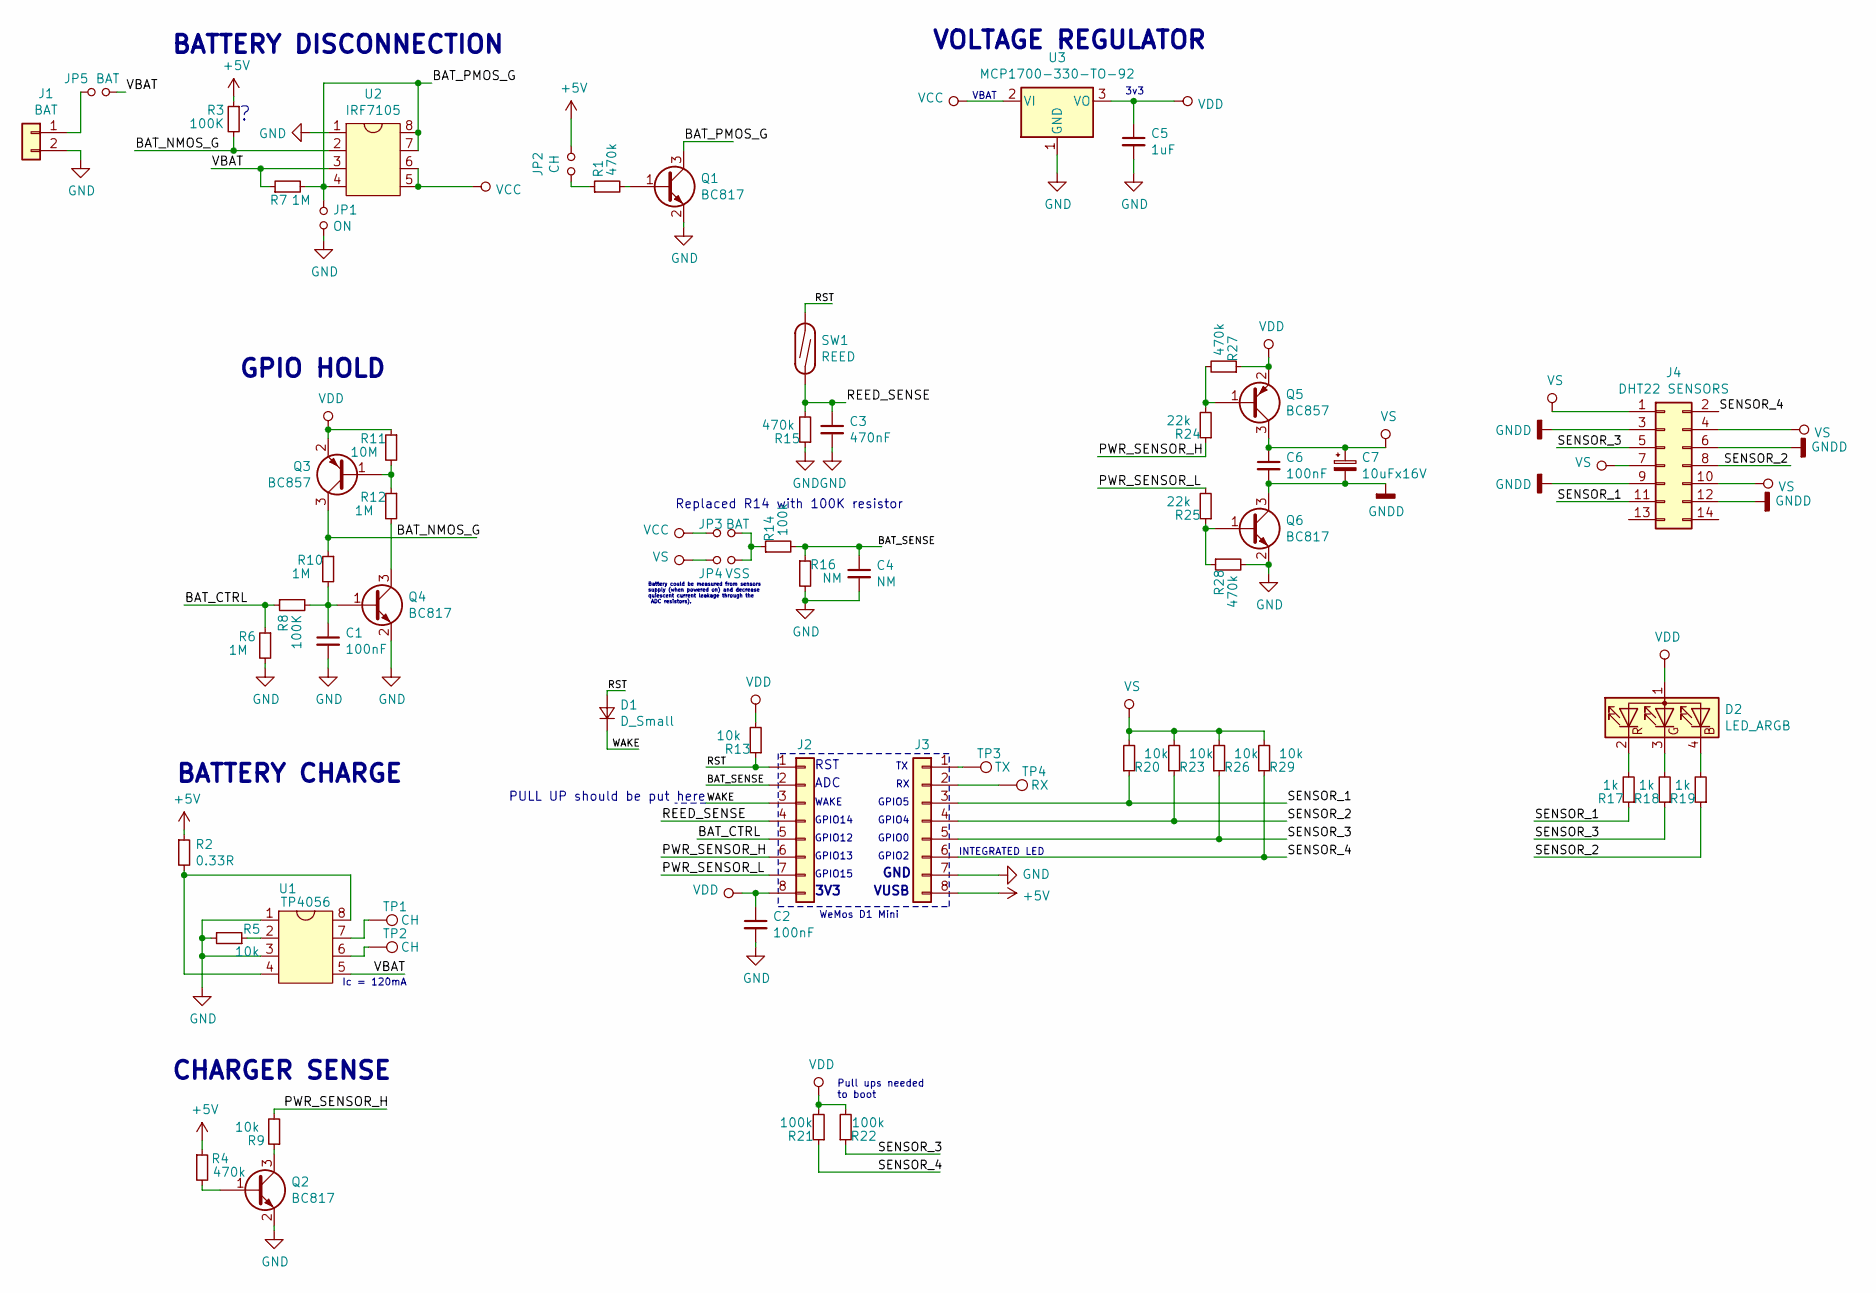
[picture p14: schematic Datalogger_esp8266.sch]

Parts:
C1, C2, C6: 100nF; C_0805
C3: 470nF; C_0805
C4: NM; C_0805
C5: 1uF; C_0805
C7: 10uFx16V; CP_Radial_D4.0mm_P2.00mm
D1: D_Small; D_MiniMELF
D2: LED_ARGB; LED_RGB_1210
J1: BAT; Pin_Header_Straight_1x02_Pitch2.54mm
J2, J3: Conn_01x08; Pin_Header_Straight_1x08_Pitch2.54mm
J4: DHT22 SENSORS; Multicomp_MC9A12-1434_2x07x2.54mm_Straight
JP1: ON; Solder_bridge
JP2: CH; Solder_bridge
JP3, JP5: BAT; Solder_bridge
JP4: VSS; Solder_bridge
Q1, Q2, Q4, Q6: BC817; SOT-23
Q3, Q5: BC857; SOT-23
R1, R4, R15, R27, R28: 470k; R_0805
R2: 0.33R; R_1206
R3, R8: 100K; R_0805
R5, R9, R13, R20, R23, R26, R29: 10k; R_0805
R6, R7, R10, R12: 1M; R_0805
R11: 10M; R_0805
R14, R21, R22: 100k; R_0805
R16: NM; R_0805
R17, R18, R19: 1k; R_0805
R24, R25: 22k; R_0805
SW1: REED; Pin_Header_Straight_1x02_Pitch2.00mm
TP1, TP2: CH; Solder_bridge
TP3: TX; Pin_Header_Straight_1x01_Pitch2.54mm
TP4: RX; Pin_Header_Straight_1x01_Pitch2.54mm
U1: TP4056; SOIC-8-1EP_3.9x4.9mm_Pitch1.27mm
U2: IRF7105; SOIC-8_3.9x4.9mm_Pitch1.27mm
U3: MCP1700-330-TO-92; TO-92_Inline_Wide

Connections:
/BAT_CTRL: J2.5, R6.1, R8.1
/BAT_NMOS_G: Q3.3 (C), R3.2, R10.1, U2.2
/BAT_PMOS_G: JP1.1, Q1.3 (C), R7.2, U2.4, U2.7, U2.8
/BAT_SENSE: C4.1, J2.2, R14.2, R16.1
/PWR_SENSOR_H: J2.6, R9.2, R24.1
/PWR_SENSOR_L: J2.7, R25.2
/REED_SENSE: C3.1, J2.4, R15.2, SW1.2
/RST: D1.2 (A), J2.1, R13.1, SW1.1
/SENSOR_1: J3.3, J4.11, R17.1, R20.1
/SENSOR_2: J3.4, J4.8, R19.1, R23.1
/SENSOR_3: J3.5, J4.5, R18.1, R22.1, R26.1
/SENSOR_4: J3.6, J4.2, R21.1, R29.1
/VBAT: JP5.1, R7.1, U1.5, U2.3
/WAKE: D1.1 (K), J2.3
GND: C1.2, C2.2, C3.2, C4.2, C5.2, J1.2, J3.7, JP1.2, Q1.2 (E), Q2.2 (E), Q4.2 (E), Q6.2 (E), R5.2, R6.2, R15.1, R16.2, R28.2, U1.1, U1.3, U2.1, U3.1 (GND)
GNDD: C6.2, C7.2, J4.3, J4.6, J4.9, J4.12, Q6.3 (C)
unnamed: C1.1, Q4.1 (B), R8.2, R10.2
unnamed: D2.2 (RK), R17.2
unnamed: D2.3 (GK), R18.2
unnamed: D2.4 (BK), R19.2
unnamed: J1.1, JP5.2
unnamed: J3.1, TP3.1
unnamed: J3.2, TP4.1
unnamed: JP3.1, JP4.1, R14.1
unnamed: Q1.1 (B), R1.2
unnamed: Q2.1 (B), R4.2
unnamed: Q2.3 (C), R9.1
unnamed: Q3.1 (B), R11.2, R12.1
unnamed: Q4.3 (C), R12.2
unnamed: Q5.1 (B), R24.2, R27.2
unnamed: Q6.1 (B), R25.1, R28.1
unnamed: R2.2, U1.4, U1.8
unnamed: R5.1, U1.2
unnamed: TP1.1, U1.7
unnamed: TP2.1, U1.6
VCC: JP3.2, U2.5, U2.6, U3.2 (VI)
VDD: C2.1, C5.1, D2.1 (A), J2.8, Q3.2 (E), Q5.2 (E), R11.1, R13.2, R21.2, R22.2, R27.1, U3.3 (VO)
VS: C6.1, C7.1, J4.1, J4.4, J4.7, J4.10, JP4.2, Q5.3 (C), R20.2, R23.2, R26.2, R29.2

Notes on the sheet:
RST
ADC
WAKE
GPIO14
GPIO12
GPIO13
GPIO15
GND
GPIO2
GPIO0
GPIO4
GPIO5
VUSB
3V3
3v3
VBAT
BATTERY CHARGE
BATTERY DISCONNECTION
VOLTAGE REGULATOR
GPIO HOLD
Pull ups needed to boot
INTEGRATED LED
Battery could be measured from sensors supply (when powered on) and decrease quiescent current leakage through the ADC resistors).
WeMos D1 Mini
CHARGER SENSE
Ic = 120mA
Replaced R14 with 100K resistor
PULL UP should be put here

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
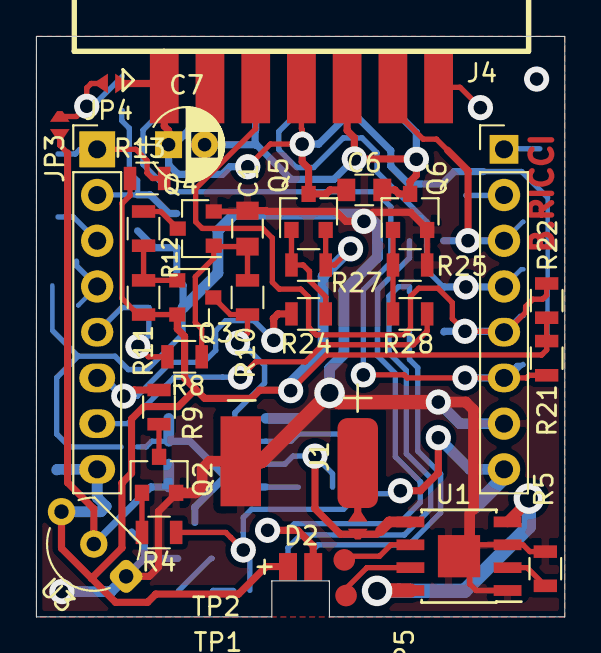
[picture p15: board Datalogger_esp8266.kicad_pcb from above]

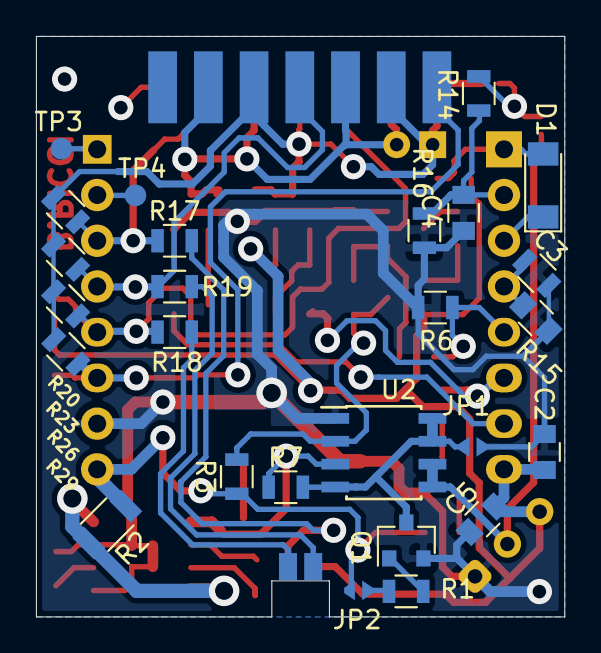
[picture p16: board Datalogger_esp8266.kicad_pcb from below]

Board: 2 copper layers, 29.4 x 32.2 mm, 60 parts (26 on the bottom side), 40 nets.
