BrunoRicci/DataloggerDHT22/(commit log)

2020-03-20 Created method "setPin" in class DHT, to use a different pin with the same object methods for each sensor
2020-03-20 One DHT object per each sensor, working fine (only random bad contact in breadboard pins). Reset citcuit corrected and data gathering fine..
    [main.cpp]
2020-04-05 String handle functions created and tested. Values from measurements are being generated and formatted correctly into the POST request to the web server. To do: Function to get dictionary and generat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
    [datalogger_config.h, main.cpp]
2020-04-13 last fatal error fixed. Class RtcMemory for memory management created and tested OK.
    [main.cpp, rtc_memory.cpp, rtc_memory.hpp]
2020-04-19 Functions to write and read measurements from archive (flash) coded and tested OK.
    To do:
    - Save pointers into rtc ram and flash/eeprom.
    - When button is holded, write rtc data to archive, load all pending packets from it, and send them to the server.
    - Generate POST request and handle server response.
    - Sincronización del tiempo con el server (usando URL /gettime) y compensar la demora del boot (usando millis()) en el próximo ciclo de sleep (restar el tiempo demorado desde el reset).
    [datalogger_config.h, main.cpp, rtc_memory.cpp, rtc_memory.hpp]
2020-04-20 Rtc class methods created. Safe disconnect and recover data methods are pending to test. These are used to save all the variables from RTC memory to no volatile memory (flash) before power supply is 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
    Time managing functions tested. Methods for this are into RtcMemory class.
    [datalogger_config.h, main.cpp, rtc_memory.cpp, rtc_memory.hpp]
2020-04-20 Function to manage battery modified, it now works in open collector mode. Tested OK.
    Function to detect charging tested too in both firmware and hardware. Care must be taken when using it, as sensors have to be powered off.
    safeDisconnect() and recoverVariables() functions tested OK.
    RtcMemory class "var" struct members are stored together and allingned by the struct. In order to access them, writeData and readData methods must be used. The address to be read is defined into "RTC_MEMORY_VARIABLES_START_BLOCK".
2020-04-23 RtcMemory::rwVar() method tested OK. Powerdown detection tested OK.
    Test "clear" method (used when format RAM).
    Make getCurrentTimeUnix function to get time from server.
    Find the way to manage the scheduled events (measuring, transmitting, etc).
2020-04-24 bug found, read main.cpp at line 212. Commit to backup.
    [datalogger_config.h, main.cpp, rtc_memory.cpp]
2020-04-24 rtc memory bug fixed.
    [rtc_memory.cpp]
2020-04-25 bug in statemachines.cpp fixed. State initialization flag was not being reset after setState() was called.
    [datalogger_config.h, main.cpp, statemachine.cpp]
2020-04-27 All functions working. Method readMeasurements() should be checked because it doesn't work when called to save the data to flash.
    Packets system has base ZERO (first packet is number 0).
    To do next:
    - In STATE_FORCE_MEASUREMENT, find the way to read and write only the number of measurements stored into RTC memory and not the maximum (12).
    - Get archive packets going from "RtcMemory::var.archive_sent_pointer" to "RtcMemory::var.archive_saved_pointer - 1" and format them to be sent into the POST request.
    Fix the maximum number of measurements per request (even to use before reading from archive, to avoid reading packets that will not fit, wasting RAM) and read a maximum of that number per op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
    [datalogger_config.h, main.cpp, rtc_memory.cpp]
2020-04-27 RtcMemory::readMeasurements() midified: Now the "amount" argument is optional and if not specified (default value=0), the method will read all the available measurements in the RTC memory, returning 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
    [rtc_memory.cpp, rtc_memory.hpp]
2020-04-27 bug at RtcMemory::readMeasurements() fixed; index was being updated before being used to write data into *data, so it saved it wrong and overflowed to other memory regions, which could cause crash.
    [main.cpp, rtc_memory.cpp]
2020-04-27 Bug in RtcMemory::readMeasurements fixed: The formula to calculate the amount of measurements to be read (when not specified in function call) was wrong and make the program crash as it obtained amou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
    [datalogger_config.h, main.cpp, rtc_memory.cpp]
2020-04-29 Configuration parameters managed to be handled without use of JSON, done with struct and a dedicated file to them, which is read, modified (if in configuration mode) and overwritten. If file won't be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
    [datalogger_config.h, main.cpp, rtc_memory.cpp]
2020-04-29 function sendMeasurements() working OK. Pending: response handling and response timeout. Log events (connection times, connection error rate, battery levels, etc.)
    -Make web interface to configure parameters (config_globals) with the proper validations. Test "handleChangeConfig()" NVM saving part.
    to do: Research for methods of faster network connection (with static IP maybe), so it won't take so long to transmit the information.
    [main.cpp, rtc_memory.cpp]
2020-04-29 bug in STATE_GET_MEASUREMENTS fixed: right before changing state to transmission, it was changed again to deep_sleep, because there was no "else" sentence that changed to deep_sleep only when transmi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
    [main.cpp]
2020-05-02 Battery check routine checked, working OK. Added safeDisconnect() after every transmission because archive pointers are not being saved and are lost after disconnection (frequent during development.)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
    [main.cpp, rtc_memory.cpp]
2020-05-03 data transmission machine improved. Pending packets iteration fixed.
    Check line 769 in main.cpp, condition is not the appropiate, it has a bug specified in coments.
    [main.cpp, rtc_memory.cpp]
2020-05-03 sendMeasuremends() fixed and simplified. Put timeout in connection and retries in packet sending to avoid errors.
    Changed network to the router (not the local PC AP) and it's working better.
    to do:
    - In FORCE_GET_MEASUREMENTS state, gather the amount of measurements and save them to archive (these are currently being saved when RTC memory is full). Use rwVariables().measurements_pointer to know how much there are.
    After forcing to save, send the measurements (the ones pending too).
    -test battery disconnection circuit controlled by GPIO.
    [main.cpp]
2020-05-04 Force transmission fixed, now it will save all the measurements stored in memory into flash (even if it was not full) and transmit them after this. Tested OK.
    Hardware: battery disconnect circuit tested OK driven with GPIO.
    to do: Improve the packets-sent system: If any unsincronization happened, the sent_pointer will only increment with the amount of packets sent, without any reference. Trouble could appear if it's wanted to read all the data from archive (from web server, for instance). In that last case, this could be avoided by not incrementing the archive_sent_packet when calling the function (not using the return value to that purpose). -> in a future, web server could send commands t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
    [datalogger_config.h]
2020-05-04 Bug in STATE_FORCE_MEASUREMENT fixed:It was not saving the last measurement into archive before transmitting to the server, so it was never seen until rtc memory got filled.
    [main.cpp]
2020-05-04 Get server time tested OK.
    Fix goDeepSleep() bug, when called, the argument sent is the time minus the elapsed time (t-millis()). Inside the function, the time is all handled in microseconds.
    To fix this, send "t" argument in milliseconds (not 60e6 but 60e6, for example) and then multiply by 1000 to convert to microseconds, to send that value to the deep sleep command from SDK.
    - Data sending schedule: It is not sent when rtc memory is full anymore, data transmission must be triggered by external wake up or by the daily hour (configurable), to say, 6:00 AM.
    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
    [datalogger_config.h, main.cpp]
2020-05-05 Hardware modified, now sensors are disconneted from both sides to decrease leakage current. Charge sense pin is now the same that PWR_SENSORS_PIN_P. It is pulled down when USB is connected and to det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
    [datalogger_config.h, main.cpp]
2020-06-24 Last firmware version + config page + other project files
    [Datalogger_esp8266.kicad_pcb, Datalogger_esp8266.sch, Datalogger_esp8266_PANELIZED.kicad_pcb, Datalogger_esp8266_backup.kicad_pcb, Datalogger_esp8266_backup_2.kicad_pcb, LIR2477_battery_holder.FCStd, Sensor_PCB.kicad_pcb, Sensor_PCB.sch]
2020-07-06 Changed some global_config struct members names for better understanding.
    Made AJAX for displaying current config into config mode web interface; send the modified ones via POST request.
2020-07-07 Added handle functions to modify device parameters from config mode web interface.
    Added functions to read and write the device parameters data from flash.
2020-07-07 bug in saveGlobals: file was not being closed and data was lost.
    -see DATETIME in ws.py -> How is epoch time being converted to datetime format? in which GMT zone?
    - See if ESP8266 actually has a physical EEPROM to save configuration parameters into.
    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
    [main.cpp]
2020-07-13 Modified default values for config_globals.
    to do: feedback animation in buttons (when code 200 received from server) in config mode.
    - Change config mode condition to the following:
    1) force wake up with magnet.
    2) While the device is up, force a reset with the magnet and hold it for 5 seconds until the LED is YELLOW.
    3) Local AP "Datalogger" is now active and web server for config mode running.
    - Add "exit" button into config mode, which will force the device to reset and force a measurement + connection to the server.
    - Add current date and time into config mode panel. (option to modify it??).
    [datalogger_config.h, main.cpp]
2020-07-15 -Added auto turn off config mode when idle (no stations/client connected to AP. - Modified config mode activation sequence.
    To do: animate buttons in config mode when the device gets and execute a command (to know it's been done OK). Server should send code 200 in order to do so.
    -Add battery level into config mode.
    -Add "exit" button into config mode.
    -Add "take measurement" into config mode: shows values into page.
    -Add "test connection" into config mode: This put the device into ST+AP mode, connects to server network, and ping into the specified server IP and port. The button will turn green or red depending if it's been succesful or not.
2020-07-26 Last commit before devices check-out. Added 100% battery condition to enter config mode.
    [data_1_15-06-2020_30-06-2020.ods, data_1_v2.csv, data_1_v2.ods, data_2_15-06-2020_30-06-2020.ods, data_2_2.csv, data_3_15-06-2020_30-06-2020.ods, data_3_2.csv, data_4_15-06-2020_30-06-2020.ods]
2020-08-06 Added function to synchronize time via serial port Added commands for entering config mode via serial. Last version uploaded to devices at 06/08/2020.
2020-08-31 Implemented daily scheduled connection. When the time of the day comes (configurable), it forces a measurement and that will lead to a connection to the server. Tested OK.
    NOTE: It will only work if device is waken up hourly (as minimum).
    [datos_23-07-2020_06-08-2020.csv, datos_23-07-2020_06-08-2020.ods]
2020-09-09 Modified config mode intarfece. Added "paths" fields (for send measurements and time synchronization) to be modifiable by the network admin.
    Added connection time field. Time of the day (UTC) when the device is connected to the network to send measurements.
    Corrected the implementation of handleChangeConfig() function in main.cpp.
    The post request values were not being correctly sent by the client (JS) and the "arg()" method wouldn't get the keys names. Now this keys can be accessed properly.
    Added 30 minutes auto turn off when in config mode.
    Modified the sendMeasurement return code condition to == 200 (it was >0, which would take 4XX return codes as successful).
    -----------------------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
    [datalogger_config.h, datalogger_configmode.py, datalogger_timesync.py, main.cpp]
2020-11-16 Added configurable static IP.
    Glitch: Server won't respond when device is connected to local network with static IP.
    Maybe it could be another network parameter bug?
    Try using different gateway address
    [3d_complete.FCStd, 3d_views.FCStd, Datalogger_3d_pcb.step, Datalogger_esp8266_BACKUP3D.kicad_pcb, Datalogger_esp8266_BACKUP3D_save.kicad_pcb, data_12-10-2020.csv, data__12-10-2020.csv, datos_10-09-2020.csv]
2020-11-18 Fixed packet_send_pointer bug.
    device_config.py tool tested OK.
    [main.cpp]
2020-11-30 removed "www" prefix in HTTP request. it must be placed in the config mode "host" field if necessary.
    -Automatic download batch tested OK.
    -HTTP_config input arguments tested OK.
    [historic_data_23-07-2020_27-11-2020.csv, historic_data_27-11-2020.csv]
2021-03-03 Added WPA2-Enterprise feature.
    Configuration web interface modified in order to modify the necessary parameters.
    Config_globals struct modified.
    HTML_config devices parameters database updated to support WPA2-Enterprise.
    Ready to test in prod.
    [data_27-11-2020_17-02-2021.csv, data_29-11-2020.csv]
2021-03-03 Corrected bugs in WPA2E connection
    [main.cpp]
